stmaxted/OverClock/Project Overview.txt

Description:
  Open Source clock powered by FPGA using 7 segment displays to display time.
  Called the OverClock because it will use a PLL within the FPGA to generate accurate timing for
  the clock, this is absolute overkill hence the name.

FPGA:
  - Something from Altera because I am familiar with their tools.

PCB CAD:
  - KiCAD

Enclosure:
  - OnShape

FPGA Toolchain:
  - Quartus Prime

Goals:
  - Total BOM cost under 100 NZD
  - Learn how to use PLLs (NOT clock dividing)
  - Time to be set via switches (UART header to be added and added as a nice to have)
  - Power input via USB-C (maybe USB-PD)
  -

FPGA Power Supply Requirements:
  - 0.778W Max
  - 220mA max transient current
  - 3 or 3.3V

Current Calcs:
  - 20mA per GPIO
  - 7 Segments * 4 Digits * 20mA = 560mA

LED Displays:
  - https://www.digikey.co.nz/product-detail/en/visual-communications-company-vcc/DSM7TA56106T/DSM7TA56106TCT-ND/8030584
  - Typical Forward Voltage: 3.1V (3.3v System voltage works nicely)
  - 4v / 20mA = 200 Ohms
  - No resistor packs in stock with Digikey so using:
  - https://www.digikey.co.nz/product-detail/en/panasonic-electronic-components/EXB-2HV221JV/Y1221CT-ND/285373

Power Supply Topology:
  - Buck Converter 5-12V in down to 4V
  - LDO from 4V to 3V to power FPGA
  - Chosen Buck Converter:
  - http://www.ti.com/product/TLV62569
  - Chosen LDO:
  - https://www.diodes.com/products/power-management/low-dropout-regulators/part/AP7365

  Decoupling Capacitor strategy:
    - One 10nF Capacitor per Vcc pin (as close as possible to each pin)
    - One large (470uF+) Capacitor on the board
