stmaxted/OverClock/OverClock Functional Block Diagram.jpg

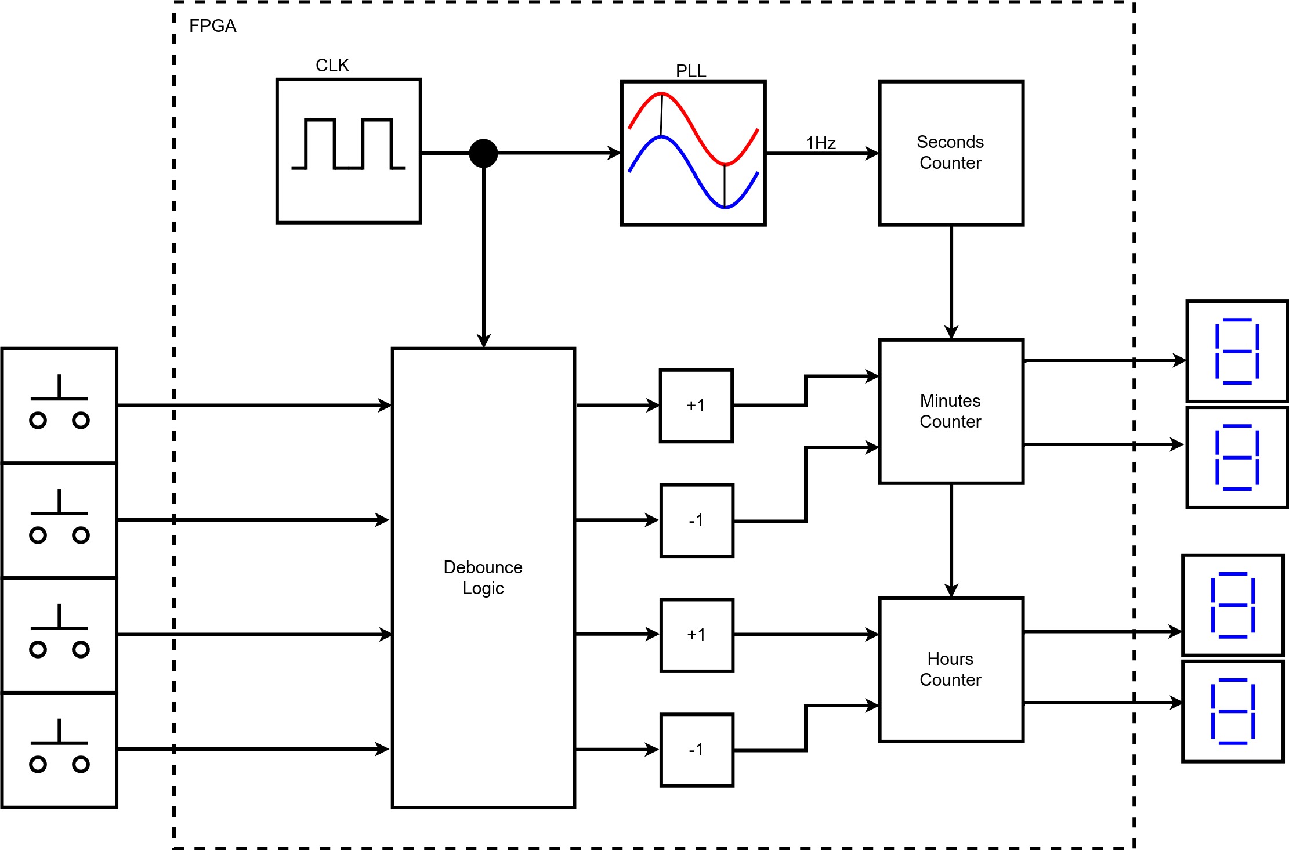
OverClock Functional Block Diagram.jpg
