stmaxted/OverClock/OverClock Hardware/OverClock Hardware.kicad_pcb

## KiCad design OverClock Hardware/OverClock Hardware.kicad_pcb (2019-02-26)

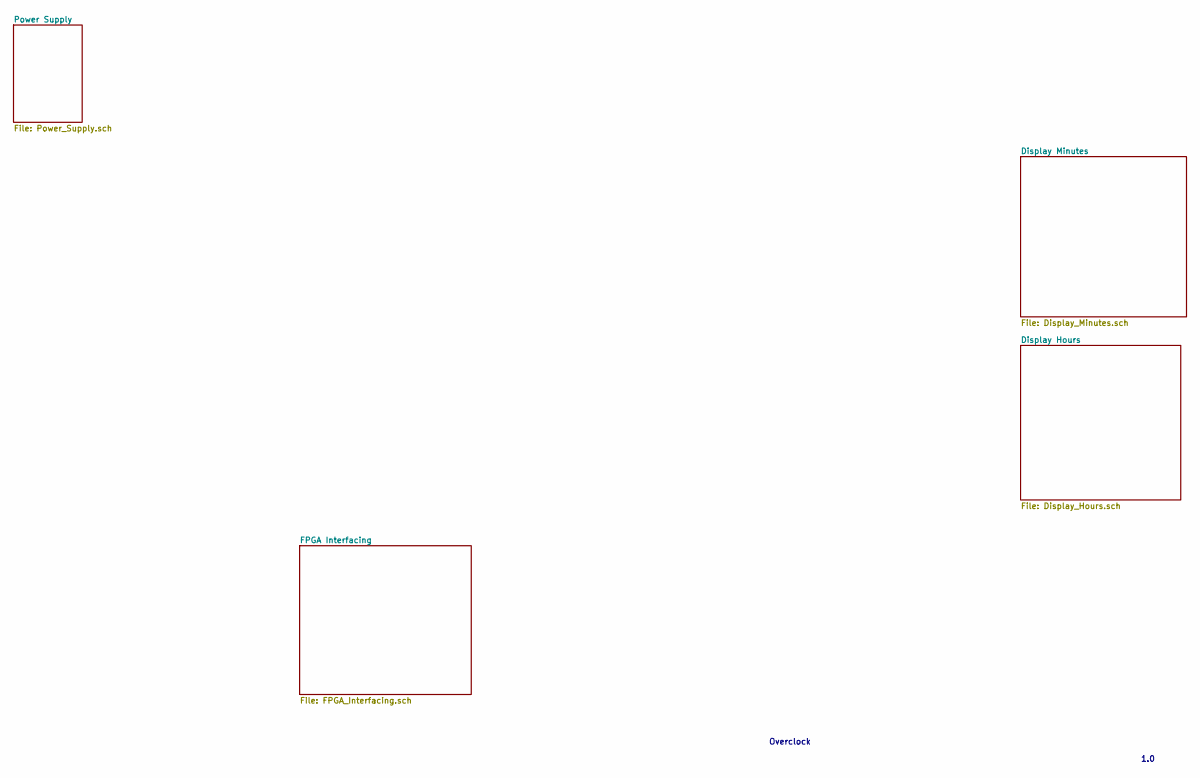
[picture p2: schematic OverClock Hardware.sch]

Notes on the sheet:
Overclock
1.0

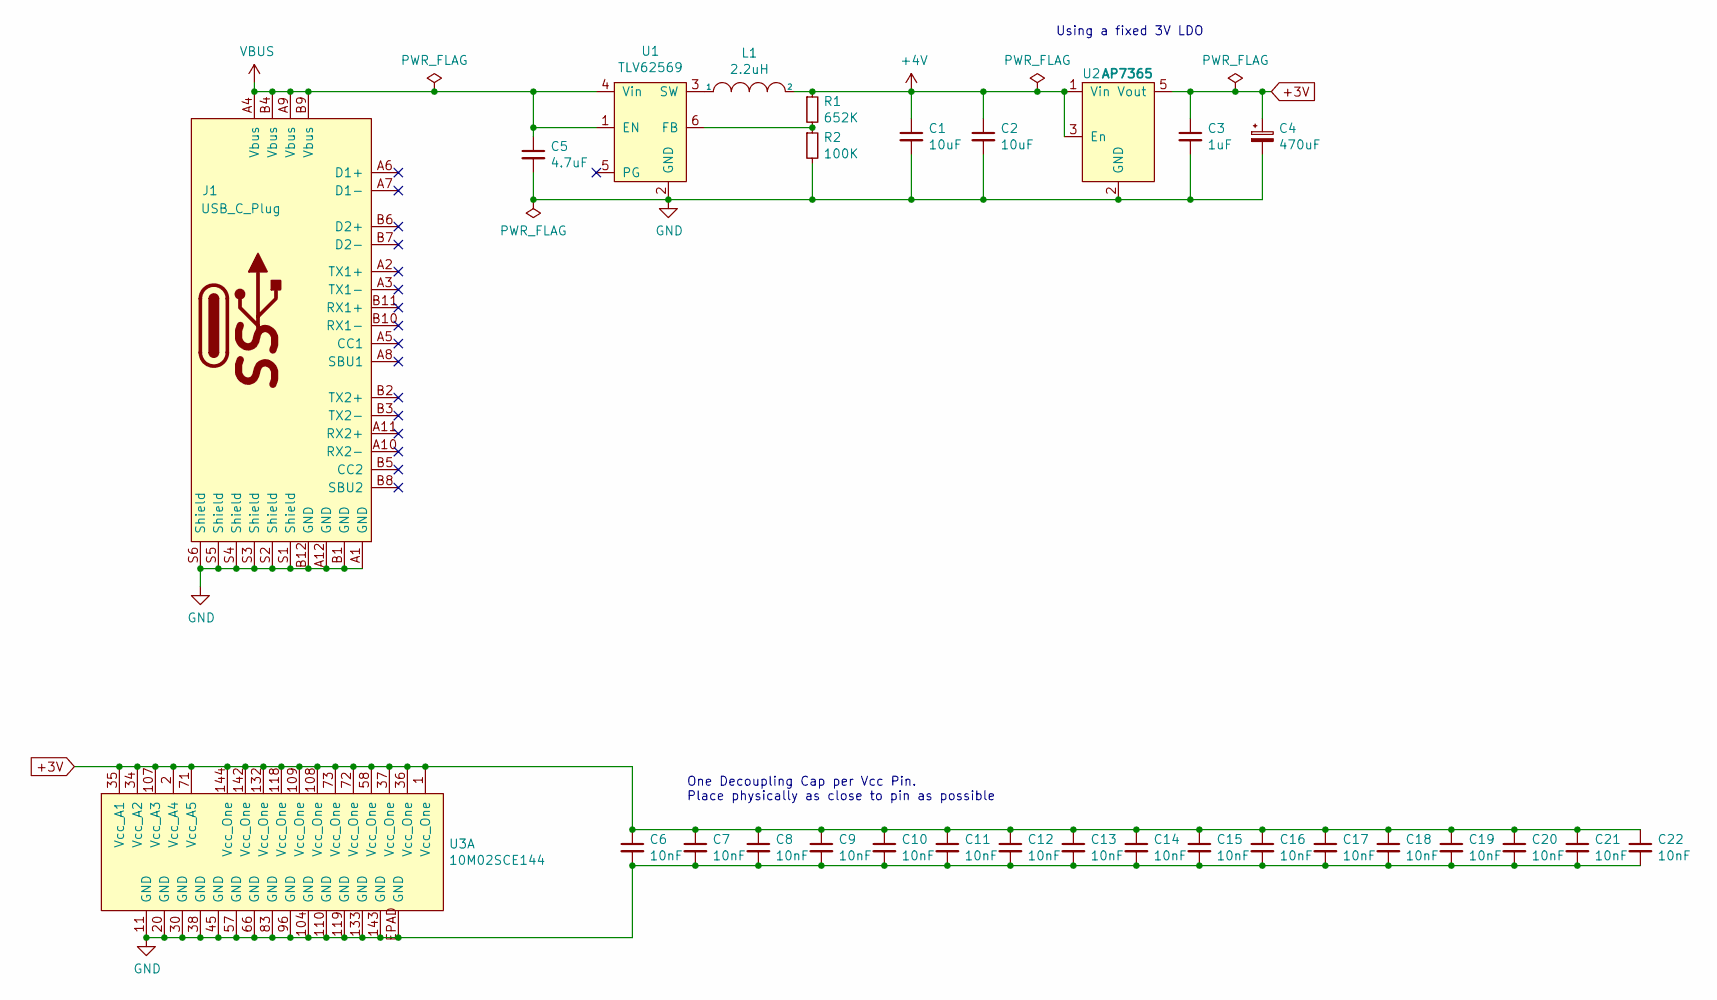
[picture p3: schematic Power_Supply.sch]

Parts:
C1, C2: 10uF; C_0805_2012Metric_Pad1.15x1.40mm_HandSolder
C3: 1uF; C_0805_2012Metric_Pad1.15x1.40mm_HandSolder
C4: 470uF; 293D
C5: 4.7uF; C_0805_2012Metric_Pad1.15x1.40mm_HandSolder
C6, C7, C8, C9, C10, C11, C12, C13, C14, C15, C16, C17, C18, C19, C20, C21, C22: 10nF; C_0603_1608Metric_Pad1.05x0.95mm_HandSolder
J1: USB_C_Plug; Hirose_USB_C_Connector
L1: 2.2uH; IHLP3232
R1: 652K; R_0805_2012Metric_Pad1.15x1.40mm_HandSolder
R2: 100K; R_0805_2012Metric_Pad1.15x1.40mm_HandSolder
U1: TLV62569; SOT23-6
U2: AP7365; SOT-23-5
U3: 10M02SCE144; QFP-144_EPAD_20x20_Pitch0.5mm

Connections:
+3V: C3.1, C4.1, C6.1, C7.1, C8.1, C9.1, C10.1, C11.1, C12.1, C13.1, C14.1, C15.1, C16.1, C17.1, C18.1, C19.1, C20.1, C21.1, C22.1, U2.5 (Vout), U3.1 (Vcc_One), U3.2 (Vcc_A4), U3.34 (Vcc_A2), U3.35 (Vcc_A1), U3.36 (Vcc_One), U3.37 (Vcc_One), U3.58 (Vcc_One), U3.71 (Vcc_A5), U3.72 (Vcc_One), U3.73 (Vcc_One), U3.107 (Vcc_A3), U3.108 (Vcc_One), U3.109 (Vcc_One), U3.118 (Vcc_One), U3.132 (Vcc_One), U3.142 (Vcc_One), U3.144 (Vcc_One); also elsewhere on the board
+4V: C1.1, C2.1, L1.2, R1.1, U2.1 (Vin), U2.3 (En); also elsewhere on the board
GND: C1.2, C2.2, C3.2, C4.2, C5.2, C6.2, C7.2, C8.2, C9.2, C10.2, C11.2, C12.2, C13.2, C14.2, C15.2, C16.2, C17.2, C18.2, C19.2, C20.2, C21.2, C22.2, J1.A1 (GND), J1.A12 (GND), J1.B1 (GND), J1.B12 (GND), J1.S1 (Shield), J1.S2 (Shield), J1.S3 (Shield), J1.S4 (Shield), J1.S5 (Shield), J1.S6 (Shield), R2.2, U1.2 (GND), U2.2 (GND), U3.11 (GND), U3.20 (GND), U3.30 (GND), U3.38 (GND), U3.45 (GND), U3.57 (GND), U3.66 (GND), U3.83 (GND), U3.96 (GND), U3.104 (GND), U3.110 (GND), U3.119 (GND), U3.133 (GND), U3.143 (GND), U3.EPAD (GND); also elsewhere on the board
unnamed: L1.1, U1.3 (SW)
unnamed: R1.2, R2.1, U1.6 (FB)
VBUS: C5.1, J1.A4 (Vbus), J1.A9 (Vbus), J1.B4 (Vbus), J1.B9 (Vbus), U1.1 (EN), U1.4 (Vin)

Notes on the sheet:
Using a fixed 3V LDO
One Decoupling Cap per Vcc Pin. Place physically as close to pin as possible

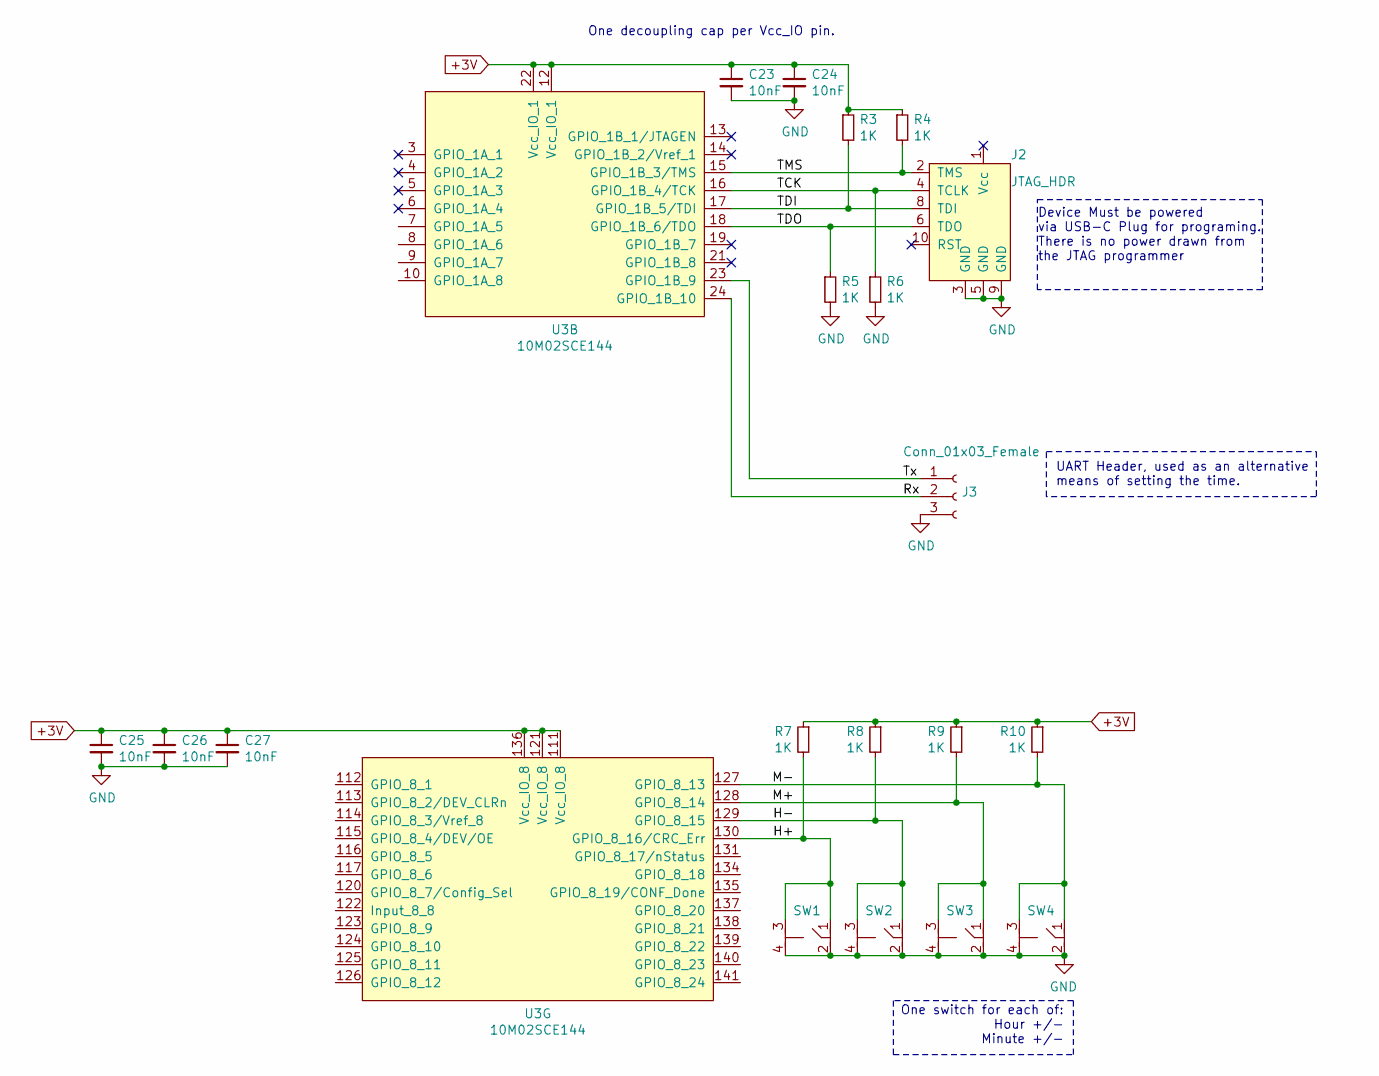
[picture p4: schematic FPGA_Interfacing.sch]

Parts:
C23, C24, C25, C26, C27: 10nF; C_0603_1608Metric_Pad1.05x0.95mm_HandSolder
J2: JTAG_HDR; PinHeader_2x05_P2.54mm_Vertical
J3: Conn_01x03_Female; Harwin_M20-89003xx_1x03_P2.54mm_Horizontal
R3, R4, R5, R6: 1K; R_0603_1608Metric_Pad1.05x0.95mm_HandSolder
R7, R8, R9, R10: 1K; R_0805_2012Metric_Pad1.15x1.40mm_HandSolder
SW1, SW2, SW3, SW4: Switch_Momentary
U3: 10M02SCE144; QFP-144_EPAD_20x20_Pitch0.5mm

Connections:
+3V: C23.1, C24.1, C25.1, C26.1, C27.1, R3.1, R4.1, R7.1, R8.1, R9.1, R10.1, U3.12 (Vcc_IO_1), U3.22 (Vcc_IO_1), U3.111 (Vcc_IO_8), U3.121 (Vcc_IO_8), U3.136 (Vcc_IO_8); also elsewhere on the board
/FPGA Interfacing/H+: R7.2, SW1.1, SW1.3, U3.130 (GPIO_8_16/CRC_Err)
/FPGA Interfacing/H-: R8.2, SW2.1, SW2.3, U3.129 (GPIO_8_15)
/FPGA Interfacing/M+: R9.2, SW3.1, SW3.3, U3.128 (GPIO_8_14)
/FPGA Interfacing/M-: R10.2, SW4.1, SW4.3, U3.127 (GPIO_8_13)
/FPGA Interfacing/Rx: J3.2, U3.24 (GPIO_1B_10)
/FPGA Interfacing/TCK: J2.4 (TCLK), R6.1, U3.16 (GPIO_1B_4/TCK)
/FPGA Interfacing/TDI: J2.8 (TDI), R3.2, U3.17 (GPIO_1B_5/TDI)
/FPGA Interfacing/TDO: J2.6 (TDO), R5.1, U3.18 (GPIO_1B_6/TDO)
/FPGA Interfacing/TMS: J2.2 (TMS), R4.2, U3.15 (GPIO_1B_3/TMS)
/FPGA Interfacing/Tx: J3.1, U3.23 (GPIO_1B_9)
GND: C23.2, C24.2, C25.2, C26.2, C27.2, J2.3 (GND), J2.5 (GND), J2.9 (GND), J3.3, R5.2, R6.2, SW1.2, SW1.4, SW2.2, SW2.4, SW3.2, SW3.4, SW4.2, SW4.4; also elsewhere on the board

Notes on the sheet:
Device Must be powered via USB-C Plug for programing. There is no power drawn from the JTAG programmer
One decoupling cap per Vcc_IO pin.
UART Header, used as an alternative means of setting the time.
One switch for each of: Hour +/- Minute +/-

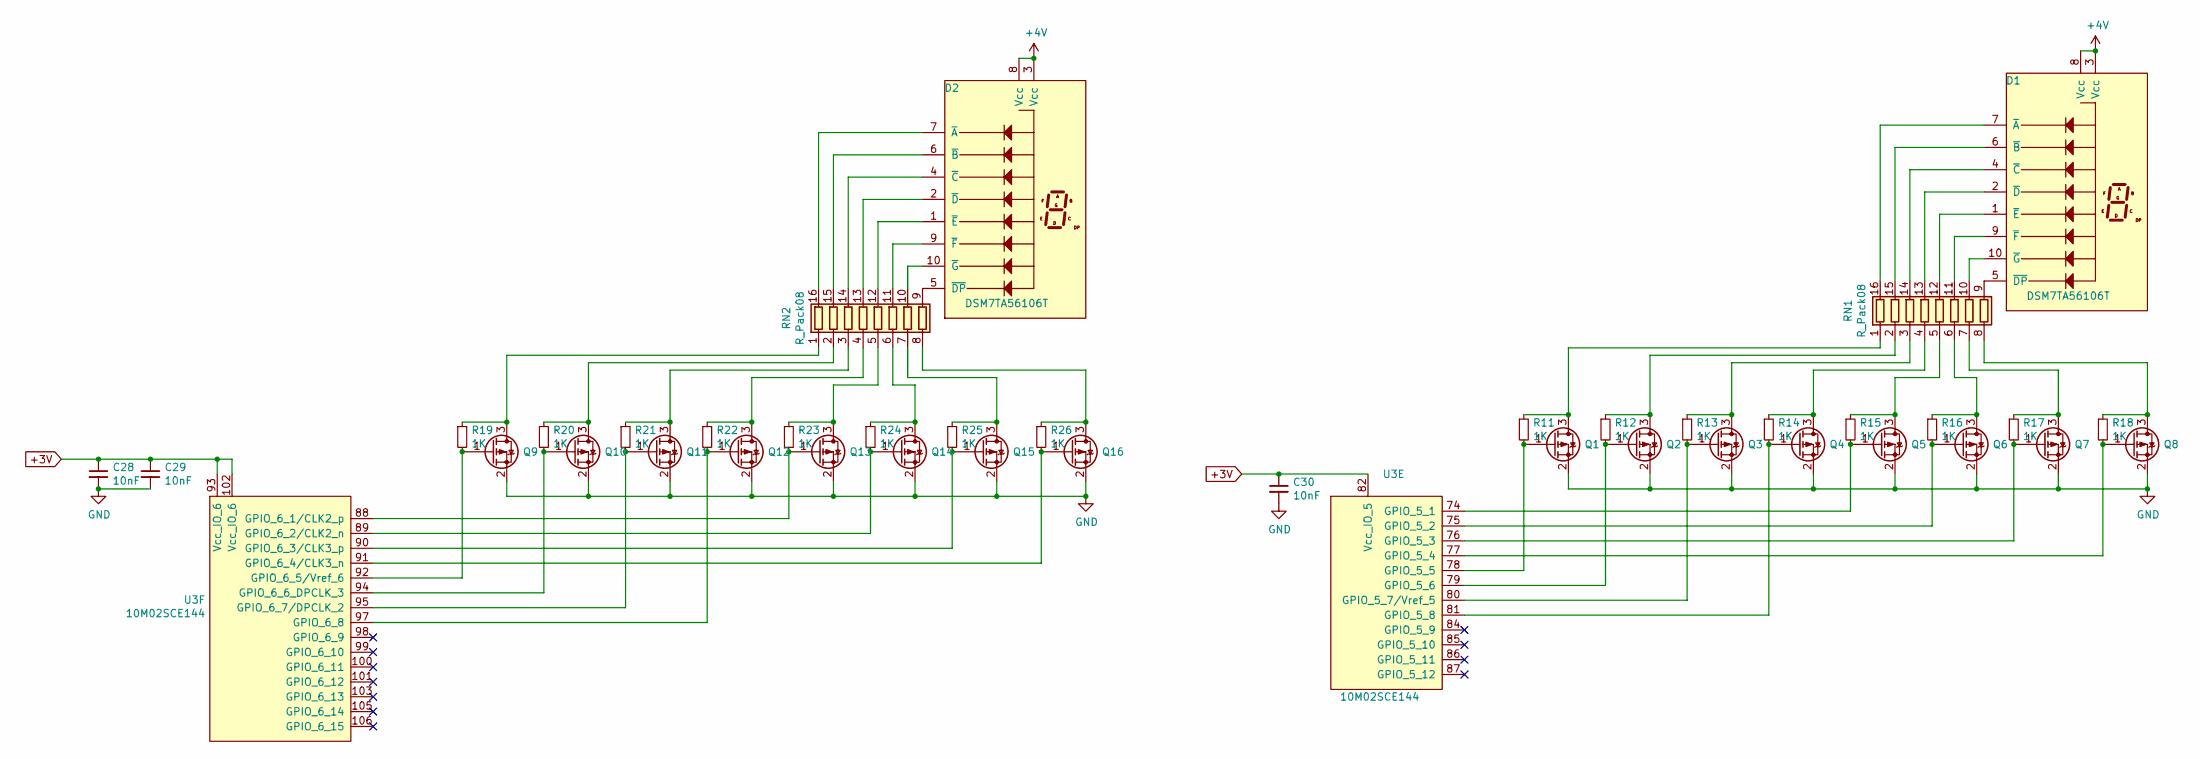
[picture p5: schematic Display_Hours.sch]

Parts:
C28, C29, C30: 10nF; C_0603_1608Metric_Pad1.05x0.95mm_HandSolder
D1, D2: DSM7TA56106T
Q1, Q2, Q3, Q4, Q5, Q6, Q7, Q8, Q9, Q10, Q11, Q12, Q13, Q14, Q15, Q16: SOT-323
R11, R12, R13, R14, R15, R16, R17, R18, R19, R20, R21, R22, R23, R24, R25, R26: 1K; R_0603_1608Metric_Pad1.05x0.95mm_HandSolder
RN1, RN2: R_Pack08; 1506_Array
U3: 10M02SCE144; QFP-144_EPAD_20x20_Pitch0.5mm

Connections:
+3V: C28.1, C29.1, C30.1, U3.82 (Vcc_IO_5), U3.93 (Vcc_IO_6), U3.102 (Vcc_IO_6); also elsewhere on the board
+4V: D1.3 (Vcc), D1.8 (Vcc), D2.3 (Vcc), D2.8 (Vcc); also elsewhere on the board
GND: C28.2, C29.2, C30.2, Q1.2 (S), Q2.2 (S), Q3.2 (S), Q4.2 (S), Q5.2 (S), Q6.2 (S), Q7.2 (S), Q8.2 (S), Q9.2 (S), Q10.2 (S), Q11.2 (S), Q12.2 (S), Q13.2 (S), Q14.2 (S), Q15.2 (S), Q16.2 (S); also elsewhere on the board
unnamed: D1.1 (~E), RN1.12 (R5.2)
unnamed: D1.2 (~D), RN1.13 (R4.2)
unnamed: D1.4 (~C), RN1.14 (R3.2)
unnamed: D1.5 (~DP), RN1.9 (R8.2)
unnamed: D1.6 (~B), RN1.15 (R2.2)
unnamed: D1.7 (~A), RN1.16 (R1.2)
unnamed: D1.9 (~F), RN1.11 (R6.2)
unnamed: D1.10 (~G), RN1.10 (R7.2)
unnamed: D2.1 (~E), RN2.12 (R5.2)
unnamed: D2.2 (~D), RN2.13 (R4.2)
unnamed: D2.4 (~C), RN2.14 (R3.2)
unnamed: D2.5 (~DP), RN2.9 (R8.2)
unnamed: D2.6 (~B), RN2.15 (R2.2)
unnamed: D2.7 (~A), RN2.16 (R1.2)
unnamed: D2.9 (~F), RN2.11 (R6.2)
unnamed: D2.10 (~G), RN2.10 (R7.2)
unnamed: Q1.1 (G), R11.2, U3.78 (GPIO_5_5)
unnamed: Q1.3 (D), R11.1, RN1.1 (R1.1)
unnamed: Q2.1 (G), R12.2, U3.79 (GPIO_5_6)
unnamed: Q2.3 (D), R12.1, RN1.2 (R2.1)
unnamed: Q3.1 (G), R13.2, U3.80 (GPIO_5_7/Vref_5)
unnamed: Q3.3 (D), R13.1, RN1.3 (R3.1)
unnamed: Q4.1 (G), R14.2, U3.81 (GPIO_5_8)
unnamed: Q4.3 (D), R14.1, RN1.4 (R4.1)
unnamed: Q5.1 (G), R15.2, U3.74 (GPIO_5_1)
unnamed: Q5.3 (D), R15.1, RN1.5 (R5.1)
unnamed: Q6.1 (G), R16.2, U3.75 (GPIO_5_2)
unnamed: Q6.3 (D), R16.1, RN1.6 (R6.1)
unnamed: Q7.1 (G), R17.2, U3.76 (GPIO_5_3)
unnamed: Q7.3 (D), R17.1, RN1.7 (R7.1)
unnamed: Q8.1 (G), R18.2, U3.77 (GPIO_5_4)
unnamed: Q8.3 (D), R18.1, RN1.8 (R8.1)
unnamed: Q9.1 (G), R19.2, U3.92 (GPIO_6_5/Vref_6)
unnamed: Q9.3 (D), R19.1, RN2.1 (R1.1)
unnamed: Q10.1 (G), R20.2, U3.94 (GPIO_6_6_DPCLK_3)
unnamed: Q10.3 (D), R20.1, RN2.2 (R2.1)
unnamed: Q11.1 (G), R21.2, U3.95 (GPIO_6_7/DPCLK_2)
unnamed: Q11.3 (D), R21.1, RN2.3 (R3.1)
unnamed: Q12.1 (G), R22.2, U3.97 (GPIO_6_8)
unnamed: Q12.3 (D), R22.1, RN2.4 (R4.1)
unnamed: Q13.1 (G), R23.2, U3.88 (GPIO_6_1/CLK2_p)
unnamed: Q13.3 (D), R23.1, RN2.5 (R5.1)
unnamed: Q14.1 (G), R24.2, U3.89 (GPIO_6_2/CLK2_n)
unnamed: Q14.3 (D), R24.1, RN2.6 (R6.1)
unnamed: Q15.1 (G), R25.2, U3.90 (GPIO_6_3/CLK3_p)
unnamed: Q15.3 (D), R25.1, RN2.7 (R7.1)
unnamed: Q16.1 (G), R26.2, U3.91 (GPIO_6_4/CLK3_n)
unnamed: Q16.3 (D), R26.1, RN2.8 (R8.1)

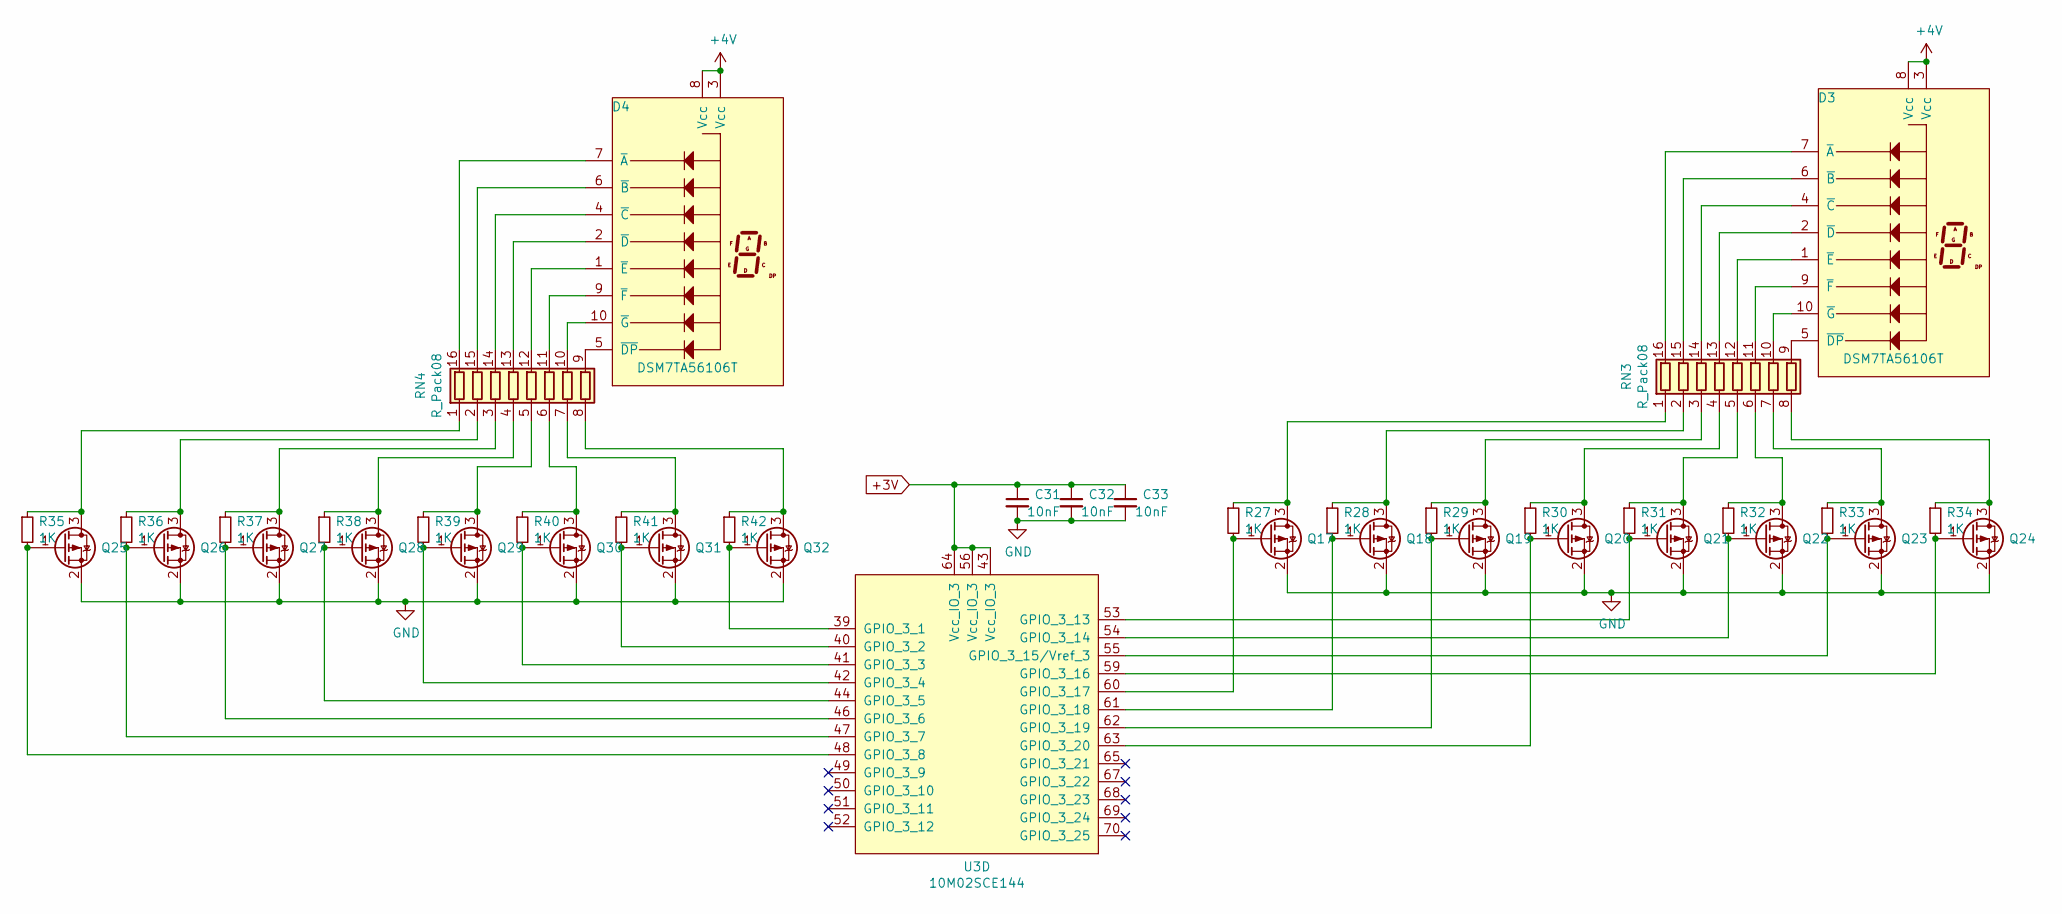
[picture p6: schematic Display_Minutes.sch]

Parts:
C31, C32, C33: 10nF; C_0603_1608Metric_Pad1.05x0.95mm_HandSolder
D3, D4: DSM7TA56106T
Q17, Q18, Q19, Q20, Q21, Q22, Q23, Q24, Q25, Q26, Q27, Q28, Q29, Q30, Q31, Q32: SOT-323
R27, R28, R29, R30, R31, R32, R33, R34, R35, R36, R37, R38, R39, R40, R41, R42: 1K; R_0603_1608Metric_Pad1.05x0.95mm_HandSolder
RN3, RN4: R_Pack08; 1506_Array
U3: 10M02SCE144; QFP-144_EPAD_20x20_Pitch0.5mm

Connections:
+3V: C31.1, C32.1, C33.1, U3.43 (Vcc_IO_3), U3.56 (Vcc_IO_3), U3.64 (Vcc_IO_3); also elsewhere on the board
+4V: D3.3 (Vcc), D3.8 (Vcc), D4.3 (Vcc), D4.8 (Vcc); also elsewhere on the board
GND: C31.2, C32.2, C33.2, Q17.2 (S), Q18.2 (S), Q19.2 (S), Q20.2 (S), Q21.2 (S), Q22.2 (S), Q23.2 (S), Q24.2 (S), Q25.2 (S), Q26.2 (S), Q27.2 (S), Q28.2 (S), Q29.2 (S), Q30.2 (S), Q31.2 (S), Q32.2 (S); also elsewhere on the board
unnamed: D3.1 (~E), RN3.12 (R5.2)
unnamed: D3.2 (~D), RN3.13 (R4.2)
unnamed: D3.4 (~C), RN3.14 (R3.2)
unnamed: D3.5 (~DP), RN3.9 (R8.2)
unnamed: D3.6 (~B), RN3.15 (R2.2)
unnamed: D3.7 (~A), RN3.16 (R1.2)
unnamed: D3.9 (~F), RN3.11 (R6.2)
unnamed: D3.10 (~G), RN3.10 (R7.2)
unnamed: D4.1 (~E), RN4.12 (R5.2)
unnamed: D4.2 (~D), RN4.13 (R4.2)
unnamed: D4.4 (~C), RN4.14 (R3.2)
unnamed: D4.5 (~DP), RN4.9 (R8.2)
unnamed: D4.6 (~B), RN4.15 (R2.2)
unnamed: D4.7 (~A), RN4.16 (R1.2)
unnamed: D4.9 (~F), RN4.11 (R6.2)
unnamed: D4.10 (~G), RN4.10 (R7.2)
unnamed: Q17.1 (G), R27.2, U3.60 (GPIO_3_17)
unnamed: Q17.3 (D), R27.1, RN3.1 (R1.1)
unnamed: Q18.1 (G), R28.2, U3.61 (GPIO_3_18)
unnamed: Q18.3 (D), R28.1, RN3.2 (R2.1)
unnamed: Q19.1 (G), R29.2, U3.62 (GPIO_3_19)
unnamed: Q19.3 (D), R29.1, RN3.3 (R3.1)
unnamed: Q20.1 (G), R30.2, U3.63 (GPIO_3_20)
unnamed: Q20.3 (D), R30.1, RN3.4 (R4.1)
unnamed: Q21.1 (G), R31.2, U3.53 (GPIO_3_13)
unnamed: Q21.3 (D), R31.1, RN3.5 (R5.1)
unnamed: Q22.1 (G), R32.2, U3.54 (GPIO_3_14)
unnamed: Q22.3 (D), R32.1, RN3.6 (R6.1)
unnamed: Q23.1 (G), R33.2, U3.55 (GPIO_3_15/Vref_3)
unnamed: Q23.3 (D), R33.1, RN3.7 (R7.1)
unnamed: Q24.1 (G), R34.2, U3.59 (GPIO_3_16)
unnamed: Q24.3 (D), R34.1, RN3.8 (R8.1)
unnamed: Q25.1 (G), R35.2, U3.48 (GPIO_3_8)
unnamed: Q25.3 (D), R35.1, RN4.1 (R1.1)
unnamed: Q26.1 (G), R36.2, U3.47 (GPIO_3_7)
unnamed: Q26.3 (D), R36.1, RN4.2 (R2.1)
unnamed: Q27.1 (G), R37.2, U3.46 (GPIO_3_6)
unnamed: Q27.3 (D), R37.1, RN4.3 (R3.1)
unnamed: Q28.1 (G), R38.2, U3.44 (GPIO_3_5)
unnamed: Q28.3 (D), R38.1, RN4.4 (R4.1)
unnamed: Q29.1 (G), R39.2, U3.42 (GPIO_3_4)
unnamed: Q29.3 (D), R39.1, RN4.5 (R5.1)
unnamed: Q30.1 (G), R40.2, U3.41 (GPIO_3_3)
unnamed: Q30.3 (D), R40.1, RN4.6 (R6.1)
unnamed: Q31.1 (G), R41.2, U3.40 (GPIO_3_2)
unnamed: Q31.3 (D), R41.1, RN4.7 (R7.1)
unnamed: Q32.1 (G), R42.2, U3.39 (GPIO_3_1)
unnamed: Q32.3 (D), R42.1, RN4.8 (R8.1)

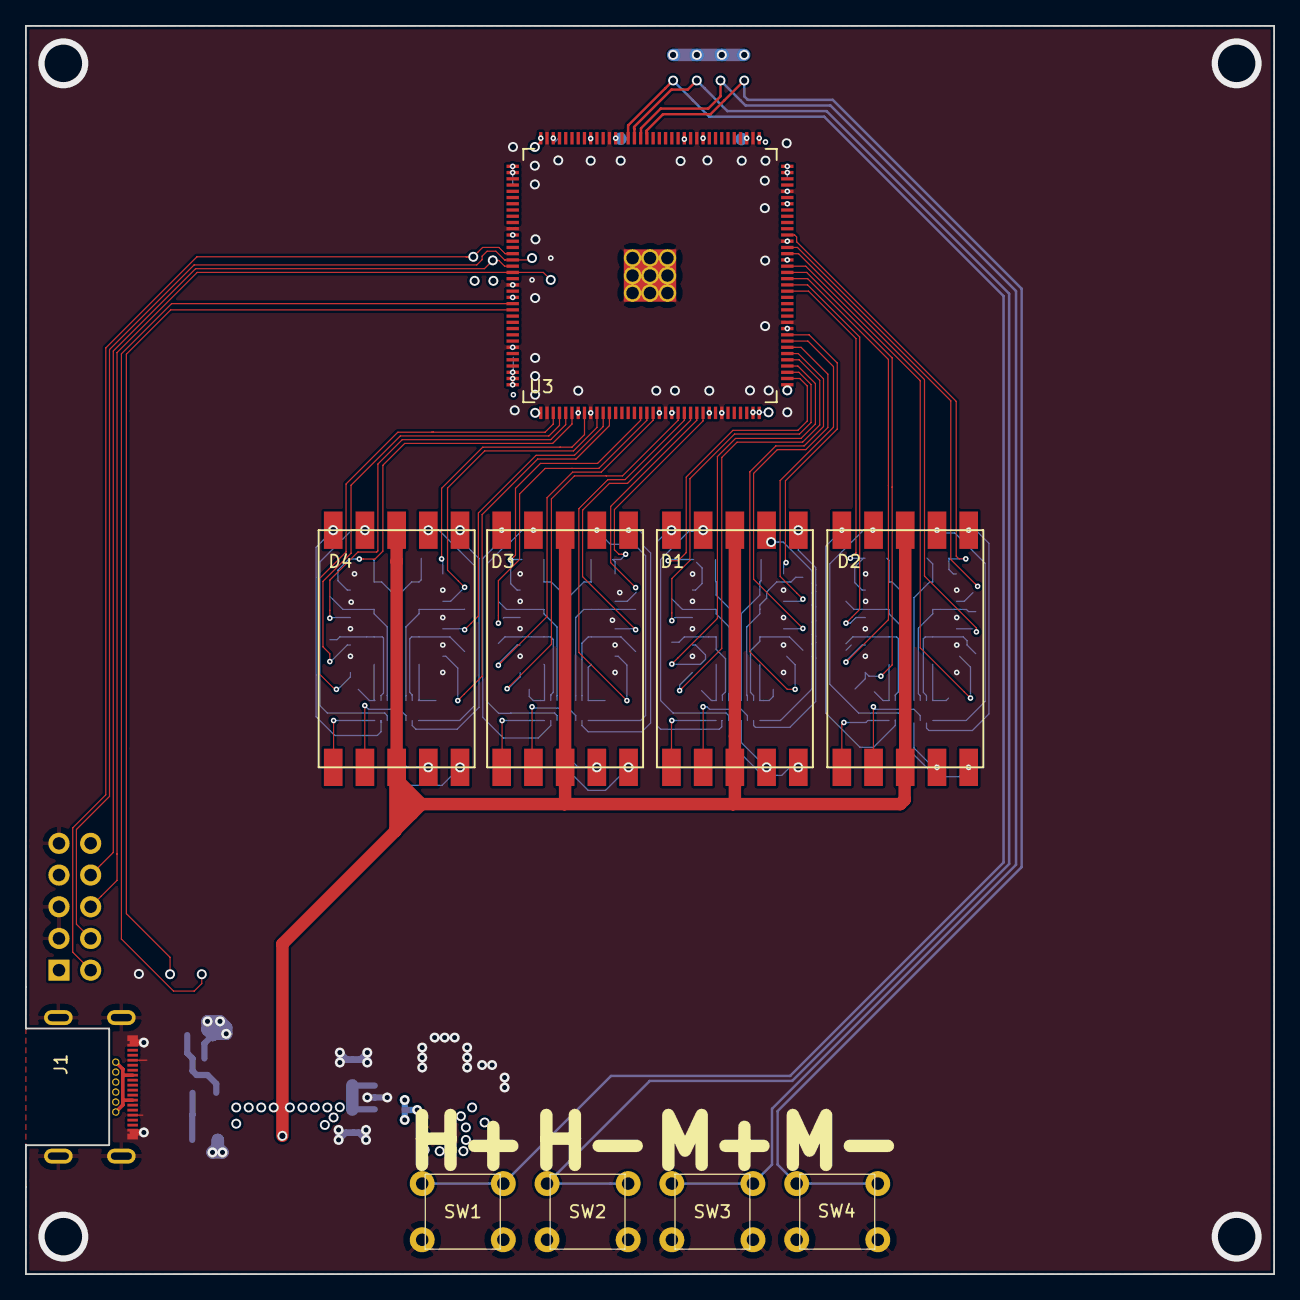
[picture p7: board OverClock Hardware.kicad_pcb from above]

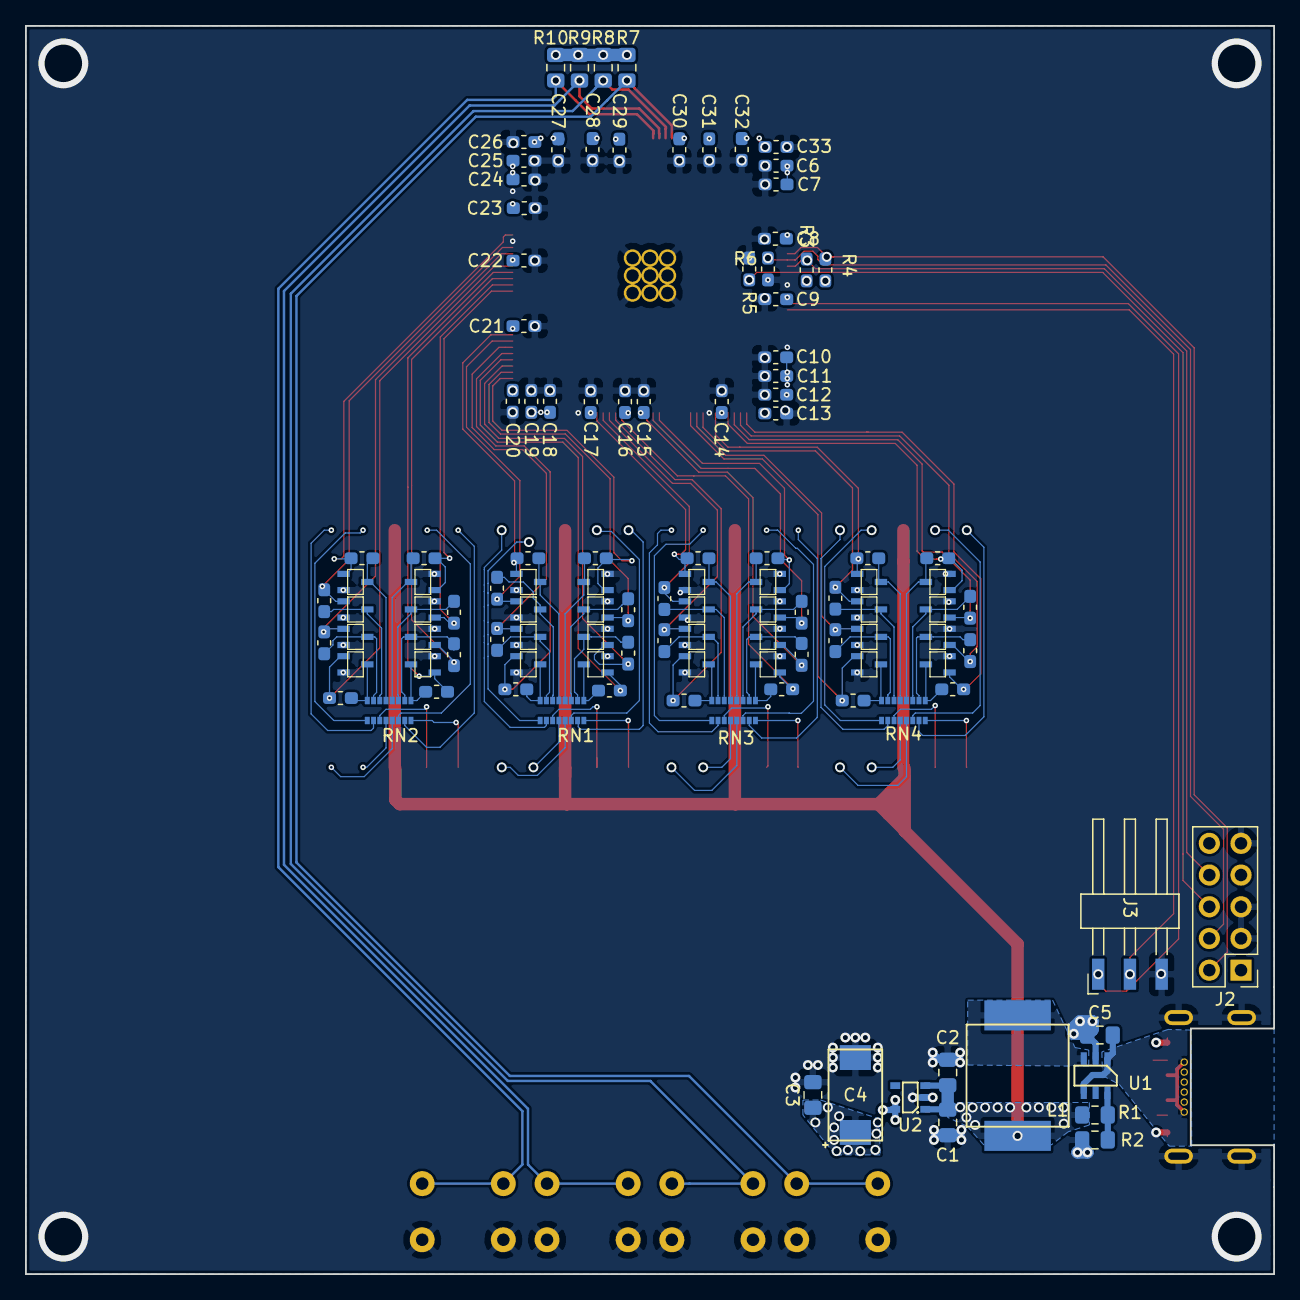
[picture p8: board OverClock Hardware.kicad_pcb from below]

Board: 4 copper layers, 100.0 x 100.0 mm, 126 parts (116 on the bottom side), 112 nets.
