stmaxted/OverClock/(commit log)

2019-01-29 Create KiCAD Project
    Created KiCAD project for hardware development
    [OverClock Hardware.kicad_pcb, OverClock Hardware.sch]
2019-02-02 Updated Project Overview and FPGA Selection Documents
    Added Power Supply section in Project Overivew Document.
    Added Backup FPGA in the same package in case I run out of logic elements.
    [10m02sc.xls]
2019-02-02 Calculated Current requirements for LED Displays
2019-02-06 Calculate Resistor Values and add Resistor Packs to Schematic
    Calculated the resistor values for 20mA through each LED segment.
    Selected a resistor pack/network.
    Added Resistor packs to KiCAD Schematic
    [OverClock Hardware.sch]
2019-02-06 Chose Buck Converter and added necessary documumentation
    [OverClock Hardware.sch]
2019-02-08 Changed Buck converter output voltage to 4V and selected LDO
    Changed the switching voltage to 4V to allow for better dropout on the LDO. Chose the Diodes Integrated AP7365 LDO and added datasheet.
2019-02-08 Added in power supply section
    Added a Buck converter to drop Vbus (5-20V) down to 4V for LEDs and the the 4V line is dropped further to 3V using a LDO to power the FPGA
    [OverClock Hardware.sch]
2019-02-08 Moved Project to Multi-Sheet Design
    [FPGA_Interfacing.sch, OverClock Hardware.sch, Power_Supply.sch]
2019-02-08 Added JTAG Header
    Added a JTAG header and interfaced it to the FPGA as per: page 16 https://www.intel.com/content/dam/www/programmable/us/en/pdfs/literature/hb/max-10/m10_guidelines.pdf
    [FPGA_Interfacing.sch, OverClock Hardware.sch, Power_Supply.sch]
2019-02-08 Fix duplicate Pullup Resistor on JTAG Header.
    Fixed error in JTAG header pullup resistor where the TDI line had 2 pullups and teh TMS had none. Both pins now have one each.
    [FPGA_Interfacing.sch]
2019-02-08 Added Decoupling strategy and started adding decoupling capacitors
    [FPGA_Interfacing.sch, Power_Supply.sch]
2019-02-08 Added Decoupling Caps for FPGA core
    [Power_Supply.sch]
2019-02-08 Interfaced Hours Digits to FPGA
    [Display_Hours.sch, FPGA_Interfacing.sch, OverClock Hardware.sch, Power_Supply.sch]
2019-02-09 Interfaced minutes digits to FPGA and added time selection methods
    Interfaced the two 7 Segment displays used for displaying the minutes to the FPGA.
    Added 4 Tactile switches to increment/decrement the hours and minutes separately.
    Added a header to allow for setting of the time via UART.
    [Display_Hours.sch, Display_Minutes.sch, FPGA_Interfacing.sch, OverClock Hardware.sch, Power_Supply.sch]
2019-02-09 Completed Schematic and ran ERC
    [Display_Hours.sch, Display_Minutes.sch, FPGA_Interfacing.sch, Power_Supply.sch]
2019-02-09 Matched symbols to footprints and generated netlist
    [Display_Hours.sch, Display_Minutes.sch, FPGA_Interfacing.sch, Power_Supply.sch]
2019-02-10 Started to route out basic blocks
    - FPGA Decoupling Caps
    - 2 of the digit MOSFETS
    - Power supply
    - FPGA location
    - Digit locations
    [Power_Supply.sch]
2019-02-15 Added Lessons Learned Document
    Added a document to track the lessons I have learned over the course of this project.
2019-02-15 Place and route Decoupling Capacitors
    Placed and routed all the decoupling capacitors for the FPGA. Created Top and bottom GND planes too for better signal integrity
    [Display_Hours.sch, Display_Minutes.sch, FPGA_Interfacing.sch, OverClock Hardware.kicad_pcb, Power_Supply.sch]
2019-02-16 Completed Initial Routing
    [Display_Hours.sch, Display_Minutes.sch, FPGA_Interfacing.sch, OverClock Hardware.kicad_pcb]
2019-02-18 Rerouted 7 Segment Displays
    Rearranged the displays for cleaner routing, also modified the schematic for some of the displays to allow for better routing.
    [Display_Hours.sch, Display_Minutes.sch, OverClock Hardware.kicad_pcb]
2019-02-26 Added Functional Block DIagram to Schematic
    [OverClock Hardware.kicad_pcb, OverClock Hardware.sch]
2019-02-26 Cleaned up board to remove DRC Errors
    [OverClock Hardware.kicad_pcb]
